Vovash25/IPZ-GestureBot/01_mechanics/NewFinalVersion/Materials/photo_2025-12-03_00-10-28.jpg

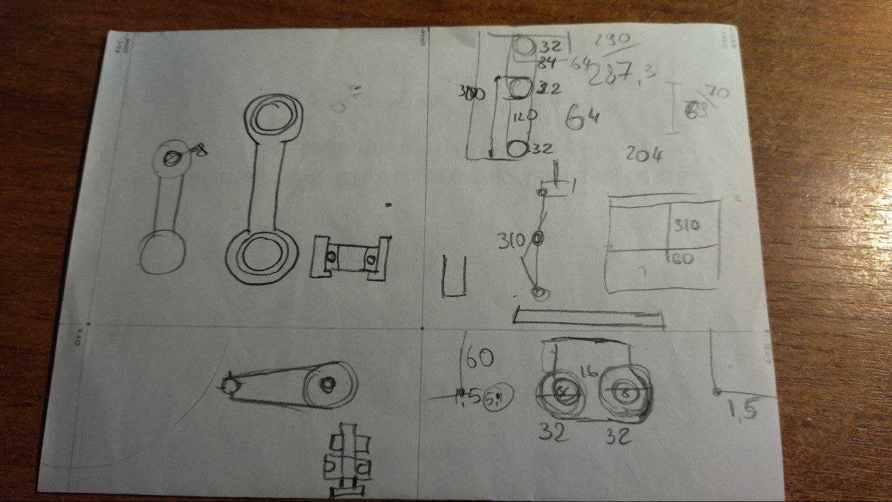
01_mechanics/NewFinalVersion/Materials/photo_2025-12-03_00-10-28.jpg
