Vovash25/IPZ-GestureBot/02_electronics/PSR.jpg

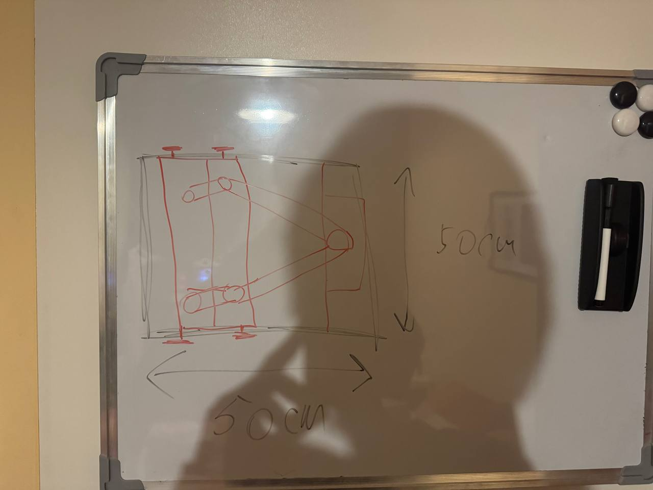
02_electronics/PSR.jpg
