Vovash25/IPZ-GestureBot/README.md

Gesture Bot Project
Projekt zespolowy - robot SCARA sterowany gestami(Gesture Bot)

Sklad zespolu:
- Vyshnovetskyi Volodymyr - Inzynier konstruktor
- Zakhar Semiankevich - Inzynier napedu i elektroniki
- Danylo Chetvertakov - Programista sterowania
- Nikita Tolstoi - Programista interfejsu
- Yehor Maksymenko - Koordynator projektu
