Vovash25/IPZ-GestureBot/02_electronics/CLR.jpg

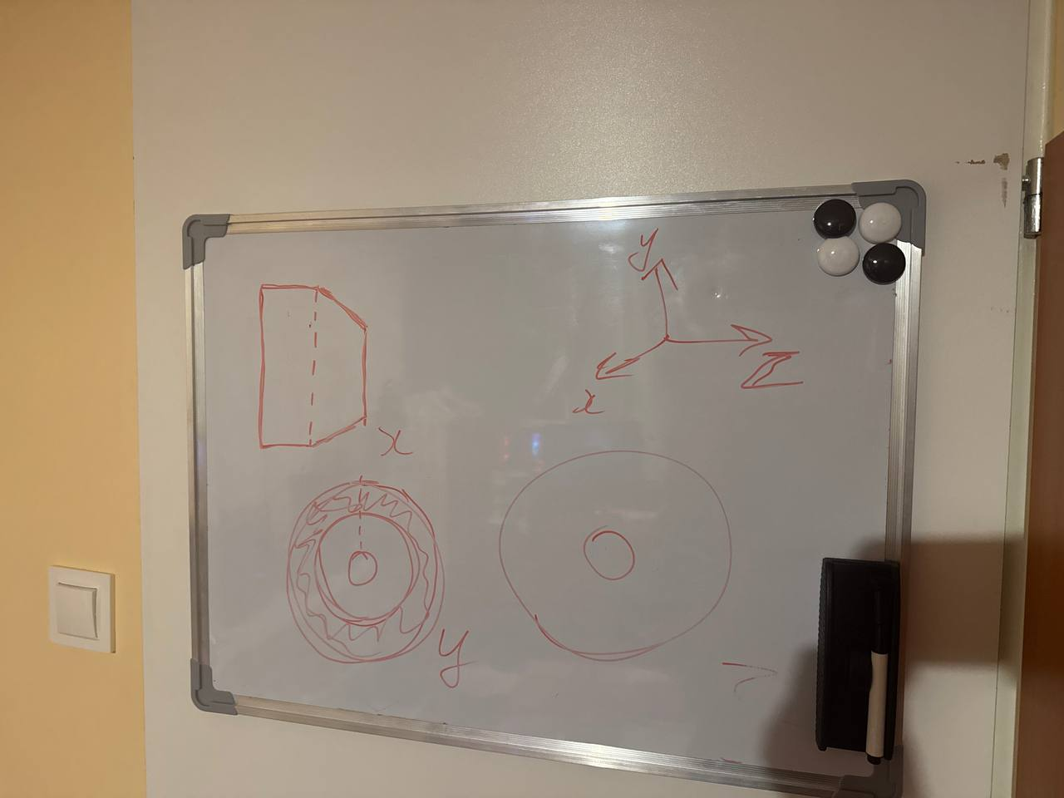
02_electronics/CLR.jpg
