Vovash25/IPZ-GestureBot/02_electronics/PPengine.jpg

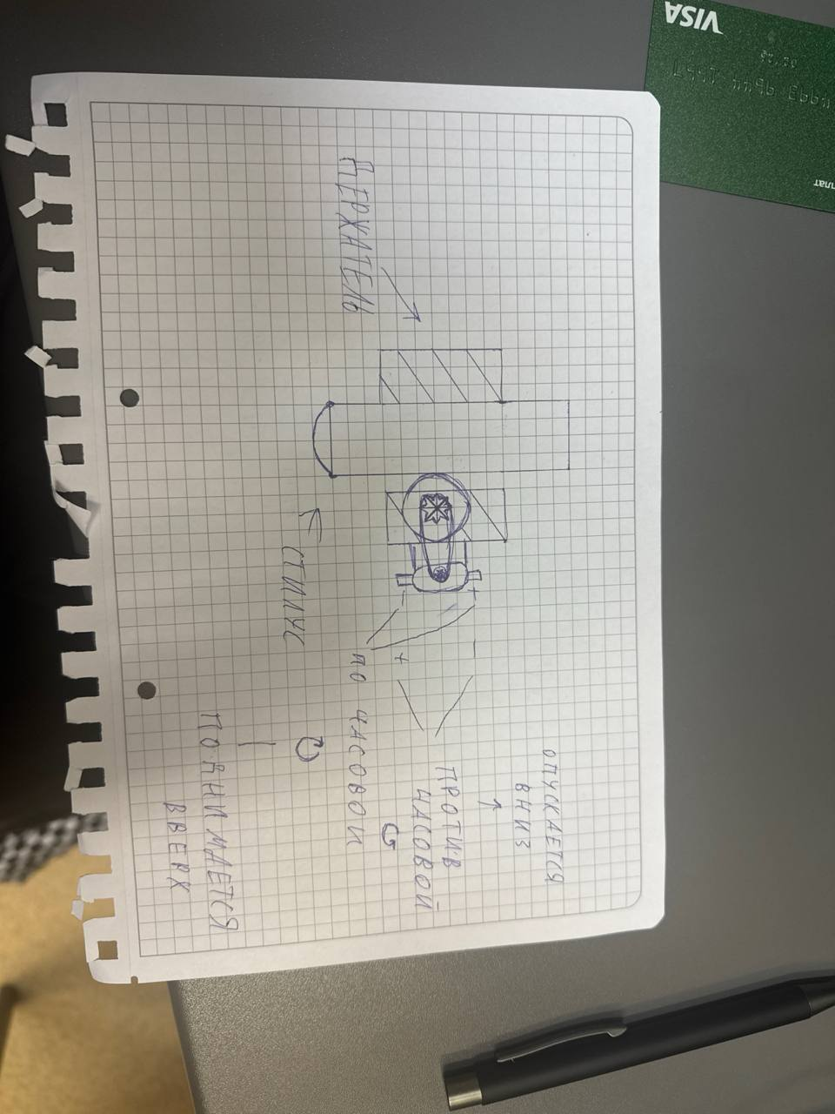
02_electronics/PPengine.jpg
