Vovash25/IPZ-GestureBot/02_electronics/PPHydra.jpg

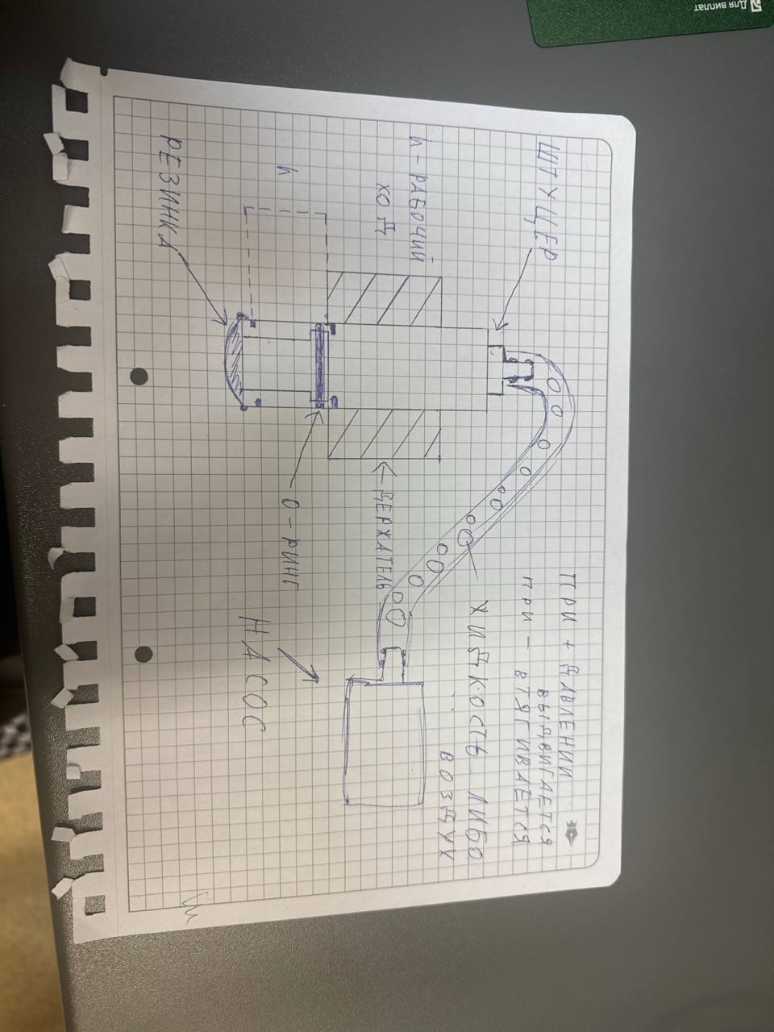
02_electronics/PPHydra.jpg
