Vovash25/IPZ-GestureBot/01_mechanics/NewFinalVersion/Materials/Materials.txt

https://abc-rc.pl/pl/products/lozysko-samonastawne-w-aluminiowej-obudowie-kp08-8mm-podpora-walka-9226.html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
https://allegro.pl/produkt/pierscien-osadczy-din-705-24-mm-nierdzewny-inox-d8f7538b-2cd4-4c75-af28-50b1281246a0?offerId=13463270287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
https://www.amazon.pl/sześciokątne-nierdzewnej-nakrętkami-podkladkami-maszynowych/dp/B0DPWYNDZF/ref=asc_df_B0DPWYNDZF?mcid=3c35ecb657433cf292733566e1e20d55&tag=plshogostdde-21&linkCode=df0&hvadid=719723093451&hvpos=&hvnetw=g&hvrand=13840144792847143092&hvpone=&hvptwo=&hvqmt=&hvdev=c&hvdvcmdl=&hvlocint=&hvlocphy=9067555&hvtargid=pla-2426400582474&hvocijid=13840144792847143092-B0DPWYNDZF-&hvexpln=0&language=pl_PL&gad_source=1&th=1
