Vovash25/IPZ-GestureBot/01_mechanics/NewFinalVersion/Materials/Lozysko.jpg

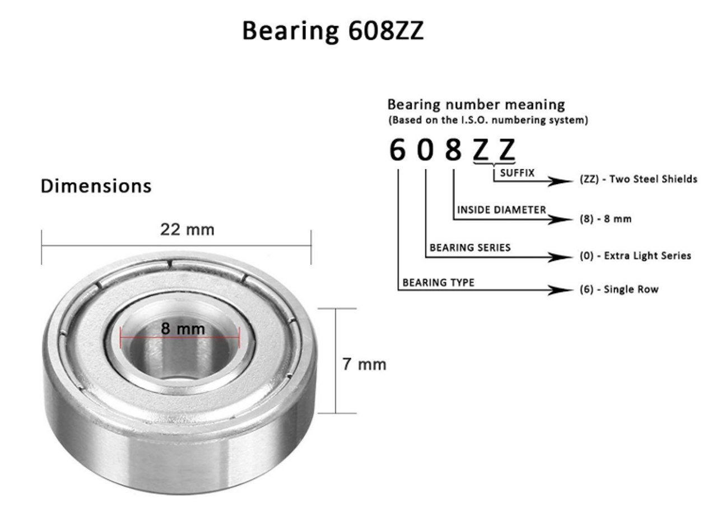
01_mechanics/NewFinalVersion/Materials/Lozysko.jpg
