Vovash25/IPZ-GestureBot/01_mechanics/NewFinalVersion/Materials/photo_2025-11-25_21-36-09.jpg

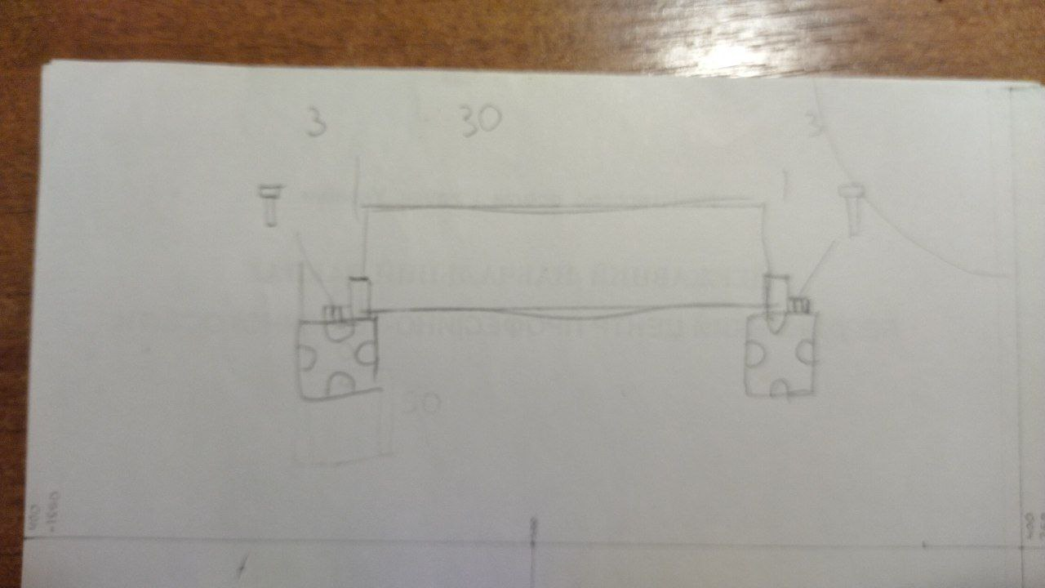
01_mechanics/NewFinalVersion/Materials/photo_2025-11-25_21-36-09.jpg
