Vovash25/IPZ-GestureBot/01_mechanics/NewFinalVersion/Materials/photo_2025-11-25_22-51-11.jpg

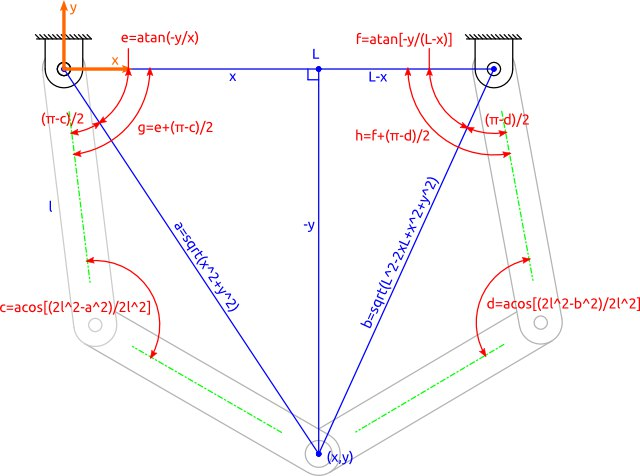
01_mechanics/NewFinalVersion/Materials/photo_2025-11-25_22-51-11.jpg
