Vovash25/IPZ-GestureBot/01_mechanics/NewFinalVersion/Materials/photo_2025-11-26_10-18-21.jpg

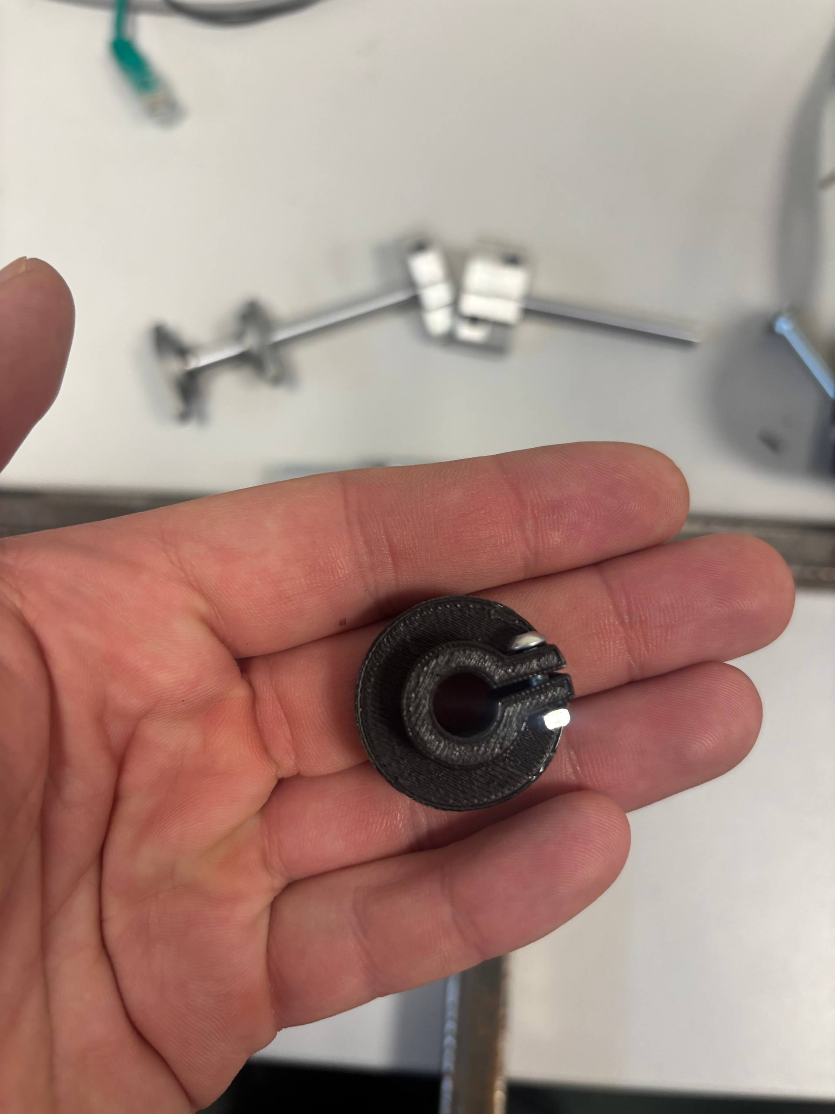
01_mechanics/NewFinalVersion/Materials/photo_2025-11-26_10-18-21.jpg
