Vovash25/IPZ-GestureBot/01_mechanics/NewFinalVersion/Materials/photo_2025-12-02_23-23-39.jpg

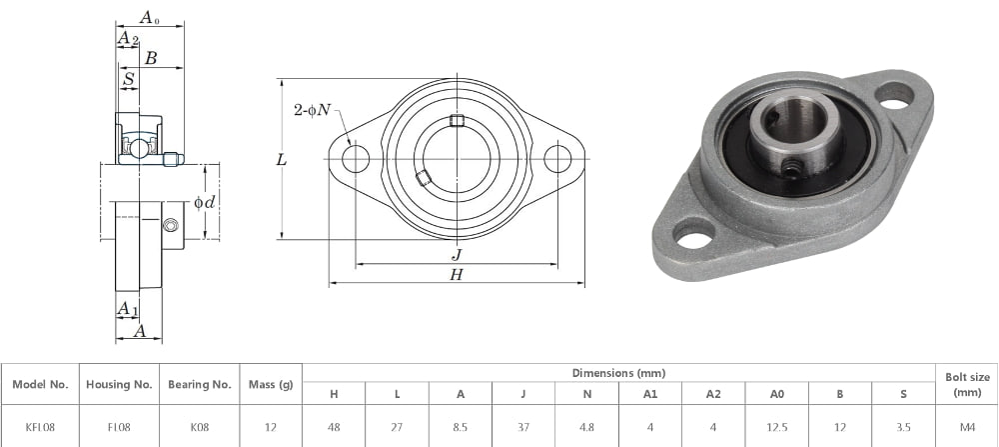
01_mechanics/NewFinalVersion/Materials/photo_2025-12-02_23-23-39.jpg
