Vovash25/IPZ-GestureBot/01_mechanics/NewFinalVersion/Materials/photo_2026-01-06_16-59-09.jpg

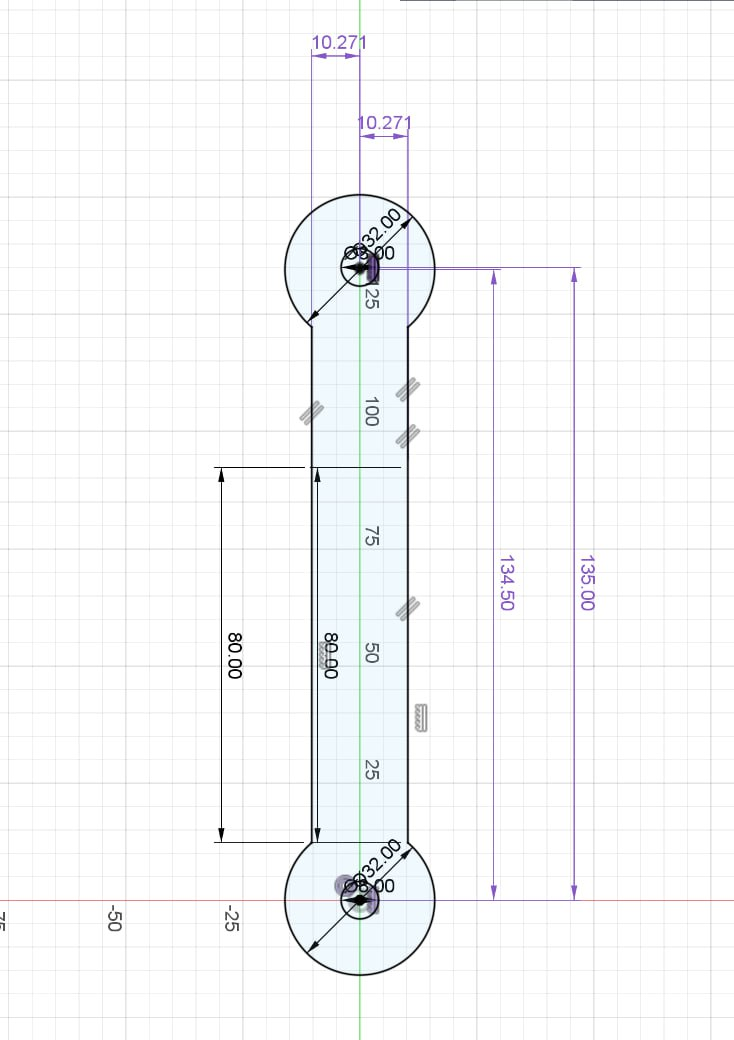
01_mechanics/NewFinalVersion/Materials/photo_2026-01-06_16-59-09.jpg
