Vovash25/IPZ-GestureBot/01_mechanics/NewFinalVersion/Materials/photo_2026-01-28_01-29-15.jpg

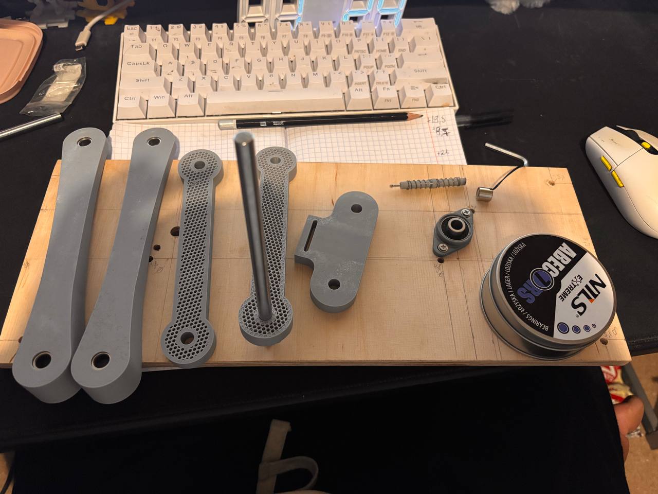
01_mechanics/NewFinalVersion/Materials/photo_2026-01-28_01-29-15.jpg
