Vovash25/IPZ-GestureBot/01_mechanics/NewFinalVersion/Palec/Palec.stl

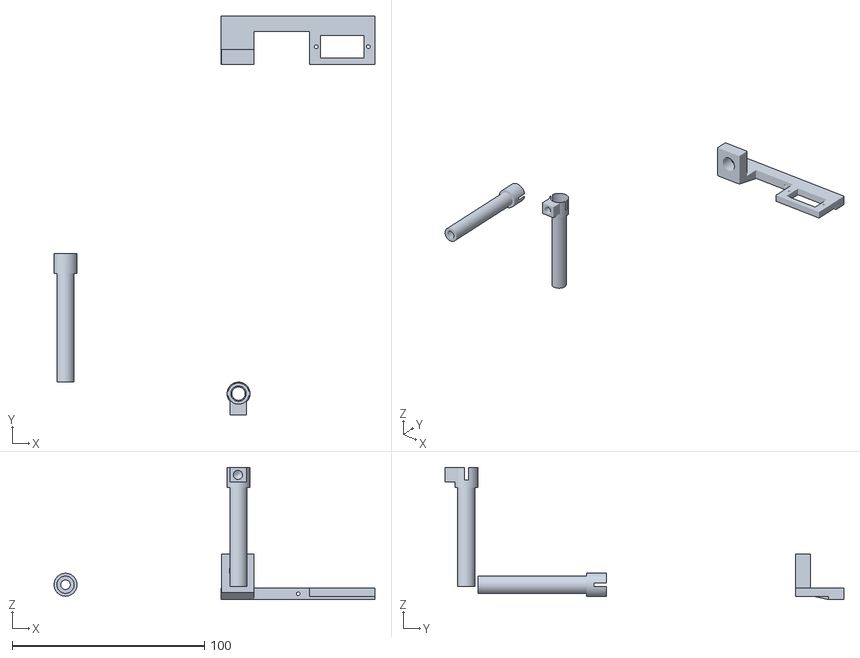
[picture p32: CAD file, 2026-06-16]
01_mechanics/NewFinalVersion/Palec/Palec.stl
167.0 x 207.3 x 68.7
