Vovash25/IPZ-GestureBot/01_mechanics/NewFinalVersion/ServoTr.stl

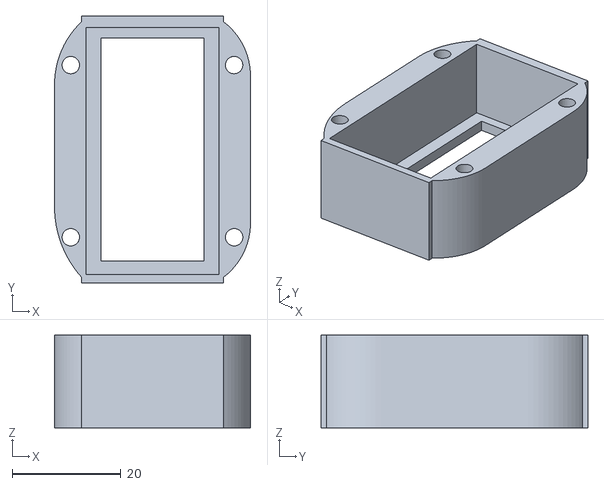
[picture p33: CAD file, 2026-06-16]
01_mechanics/NewFinalVersion/ServoTr.stl
36.0 x 49.0 x 17.0
