Vovash25/IPZ-GestureBot/01_mechanics/TubePalec2.0.stl

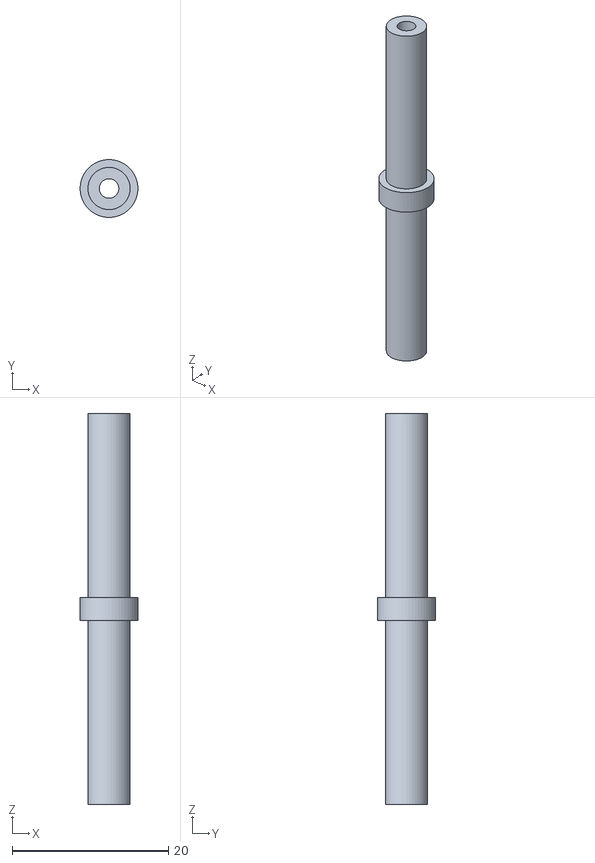
[picture p34: CAD file, 2026-01-28]
01_mechanics/TubePalec2.0.stl
7.39 x 7.40 x 50.0
