Vovash25/IPZ-GestureBot/01_mechanics/NewFinalVersion/firstArm(krotka).stl

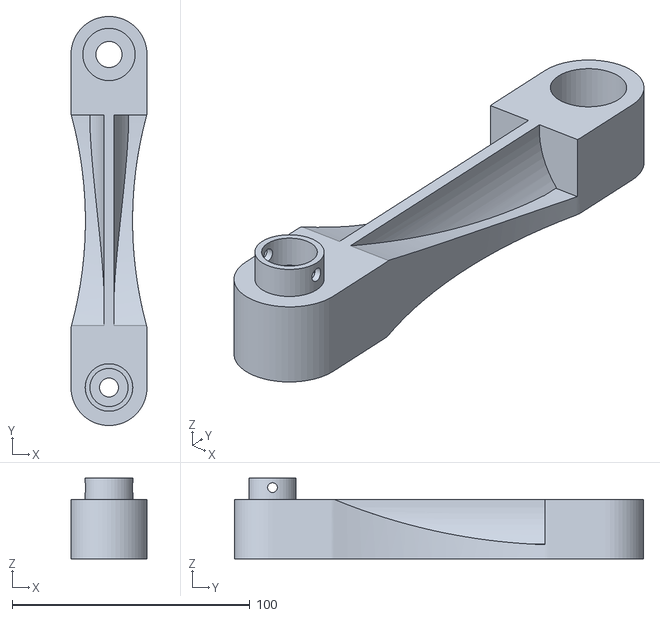
[picture p35: CAD file, 2026-06-16]
01_mechanics/NewFinalVersion/firstArm(krotka).stl
32.0 x 171.9 x 34.0
