Vovash25/IPZ-GestureBot/01_mechanics/Plaform 2.0.stl

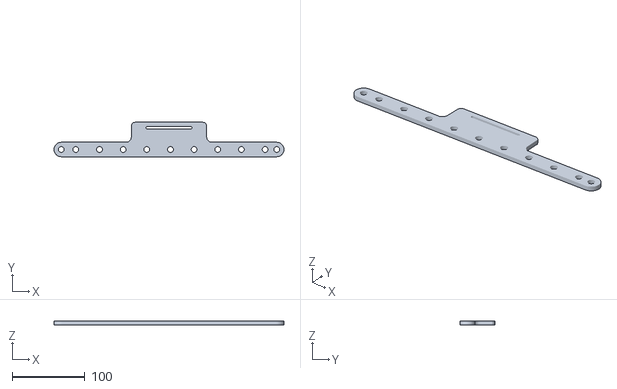
[picture p36: CAD file, 2026-01-28]
01_mechanics/Plaform 2.0.stl
316.0 x 47.5 x 5.00
