Vovash25/IPZ-GestureBot/01_mechanics/Detail1.2.stl

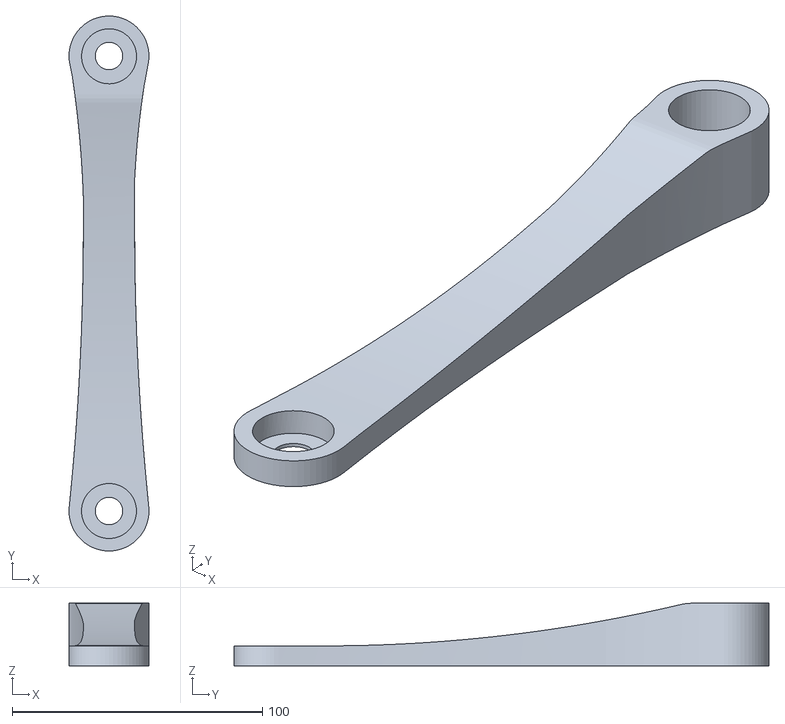
[picture p37: CAD file, 2026-01-28]
01_mechanics/Detail1.2.stl
32.0 x 214.0 x 25.0
