Vovash25/IPZ-GestureBot/01_mechanics/NewFinalVersion/MiddleConnections.stl

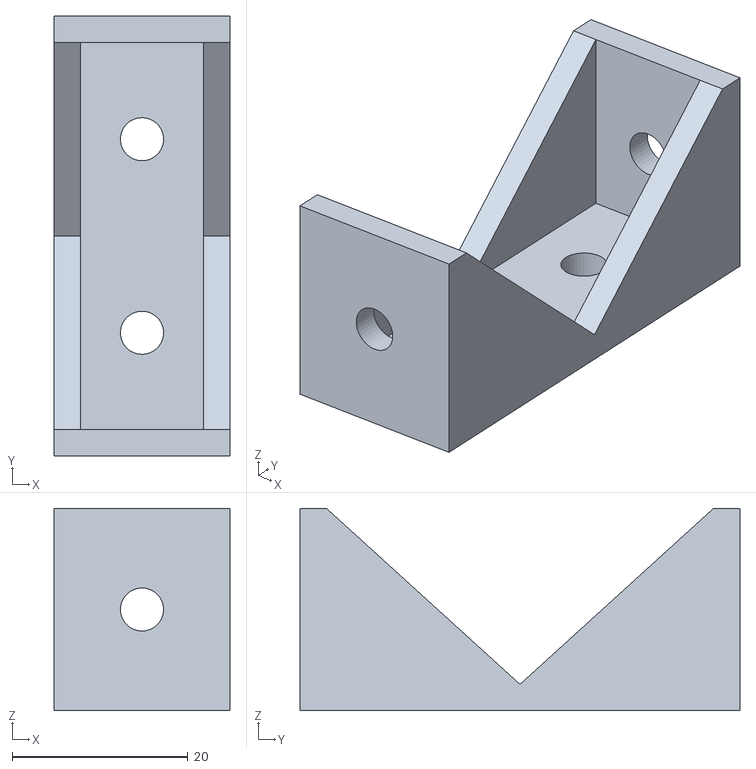
[picture p38: CAD file, 2026-06-16]
01_mechanics/NewFinalVersion/MiddleConnections.stl
20.0 x 50.0 x 23.0
