Vovash25/IPZ-GestureBot/01_mechanics/Detail2.0.stl

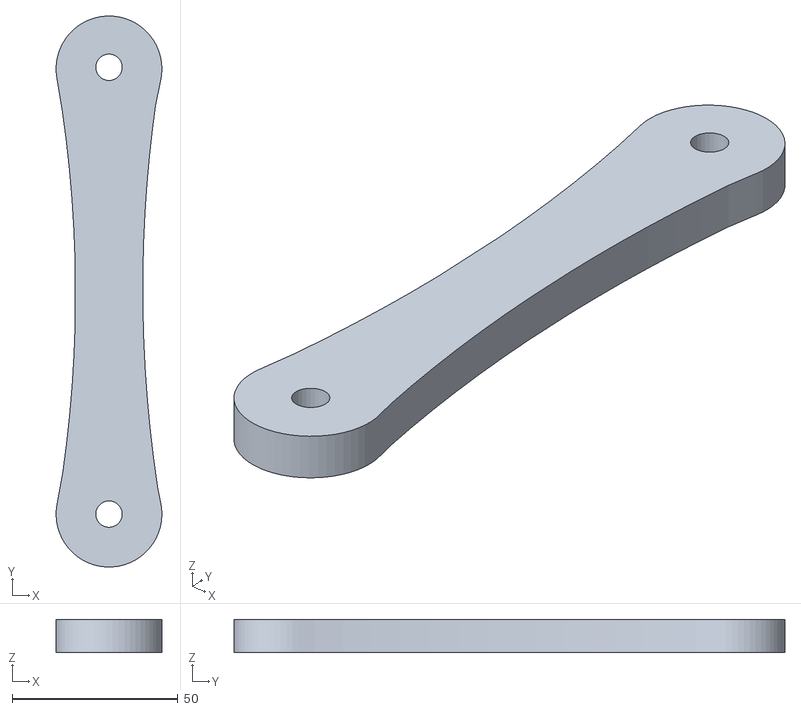
[picture p39: CAD file, 2026-01-28]
01_mechanics/Detail2.0.stl
32.0 x 166.5 x 10.0
