Vovash25/IPZ-GestureBot/01_mechanics/NewFinalVersion/Arm(dluga).stl

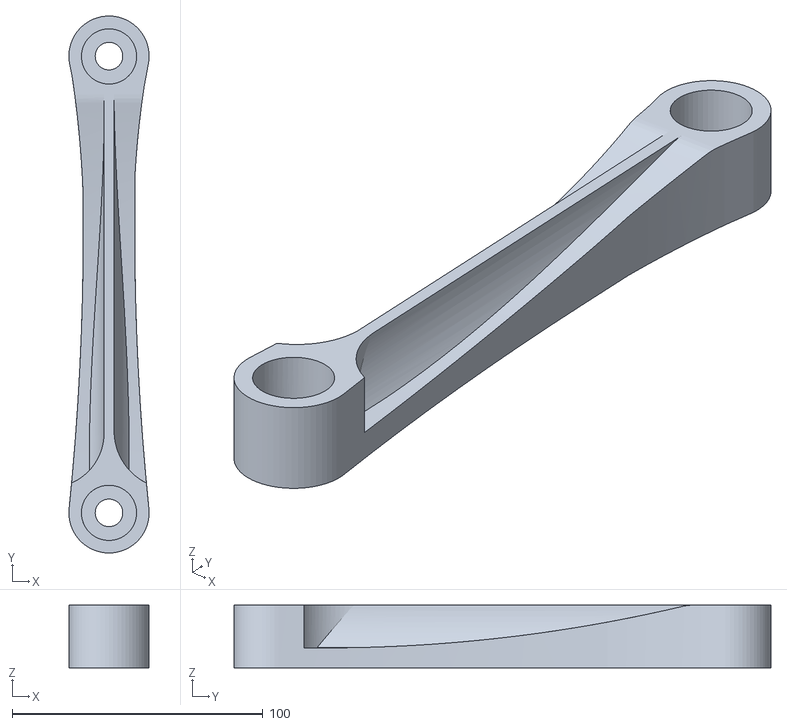
[picture p40: CAD file, 2026-06-16]
01_mechanics/NewFinalVersion/Arm(dluga).stl
32.0 x 214.0 x 25.0
