Vovash25/IPZ-GestureBot/01_mechanics/Detail1.0.stl

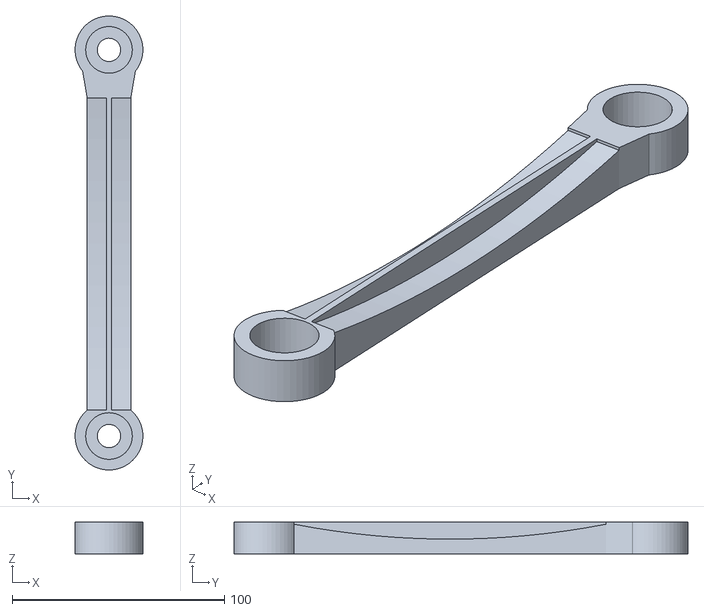
[picture p41: CAD file, 2026-01-28]
01_mechanics/Detail1.0.stl
32.0 x 214.0 x 15.0
