Vovash25/IPZ-GestureBot/01_mechanics/NewFinalVersion/SmallConnection.stl

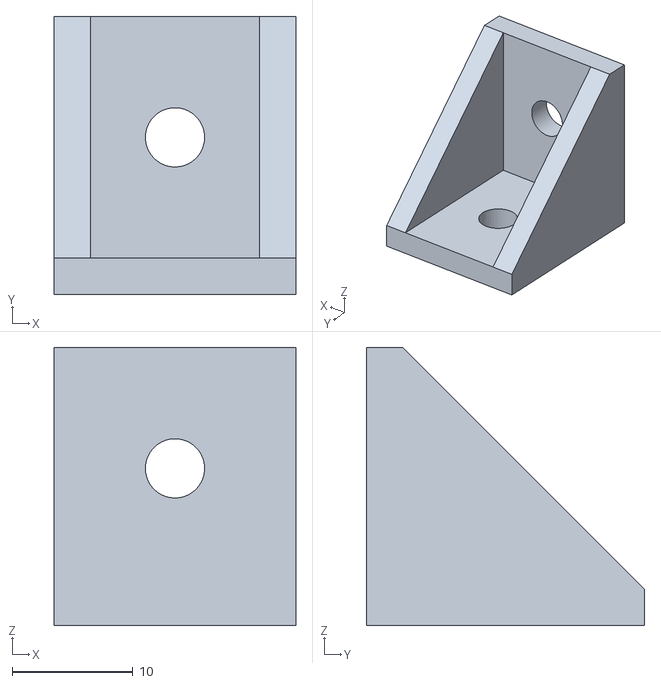
[picture p42: CAD file, 2026-06-16]
01_mechanics/NewFinalVersion/SmallConnection.stl
20.0 x 23.0 x 23.0
