Vovash25/IPZ-GestureBot/01_mechanics/3030_M3_stl.stl

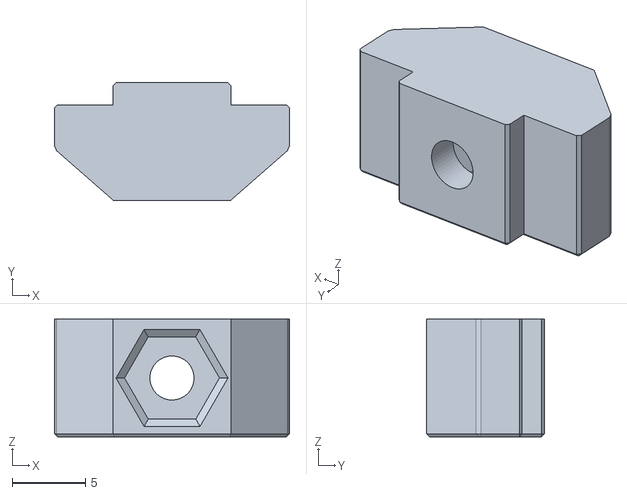
[picture p43: CAD file, 2025-12-03]
01_mechanics/3030_M3_stl.stl
16.0 x 8.00 x 8.00
