Vovash25/IPZ-GestureBot/01_mechanics/NewFinalVersion/Connections.stl

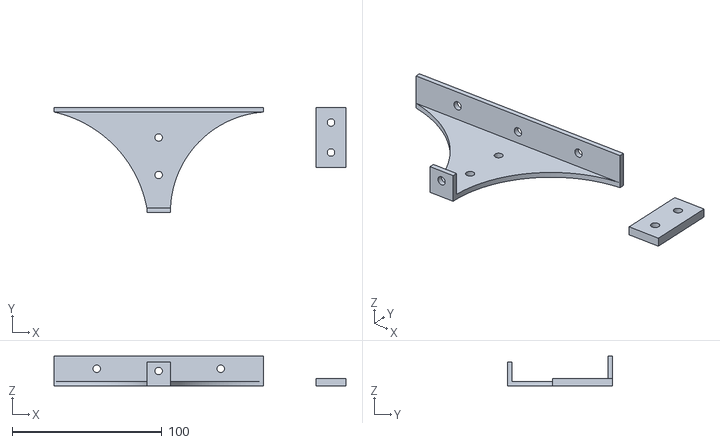
[picture p44: CAD file, 2026-06-16]
01_mechanics/NewFinalVersion/Connections.stl
194.9 x 70.0 x 20.0
