Vovash25/IPZ-GestureBot/01_mechanics/NewFinalVersion/ServoDetail.stl

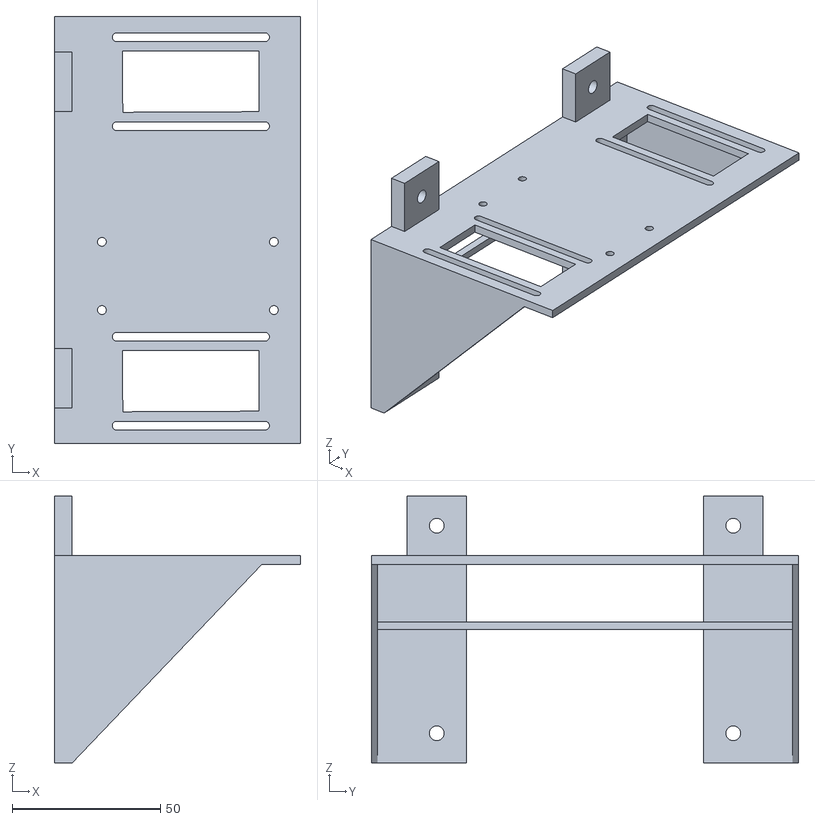
[picture p45: CAD file, 2026-06-16]
01_mechanics/NewFinalVersion/ServoDetail.stl
83.0 x 144.0 x 90.0
