Vovash25/IPZ-GestureBot/01_mechanics/NewFinalVersion/ramka.stl

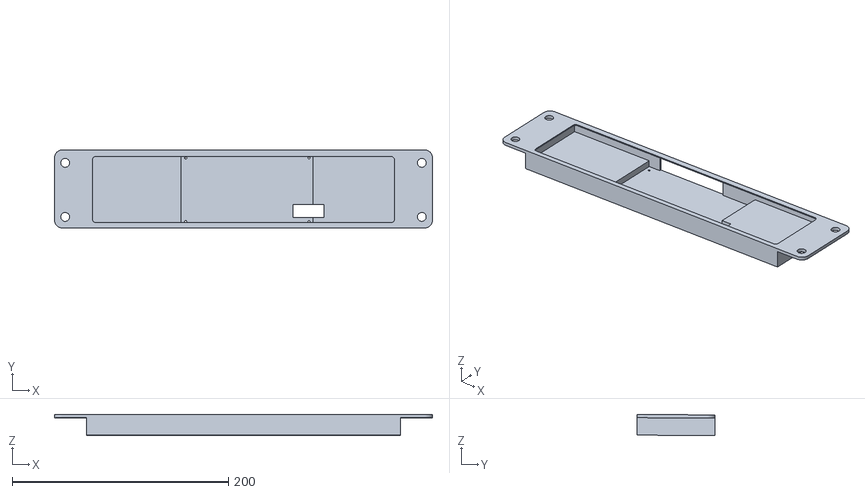
[picture p46: CAD file, 2026-06-16]
01_mechanics/NewFinalVersion/ramka.stl
349.7 x 72.2 x 19.5
