Vovash25/IPZ-GestureBot/01_mechanics/Platform.stl

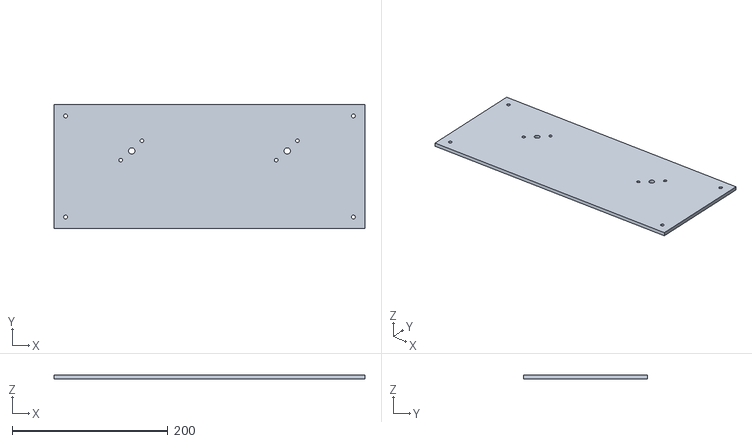
[picture p47: CAD file, 2025-12-03]
01_mechanics/Platform.stl
400.0 x 160.0 x 5.00
