Vovash25/IPZ-GestureBot/01_mechanics/Clutch.stl

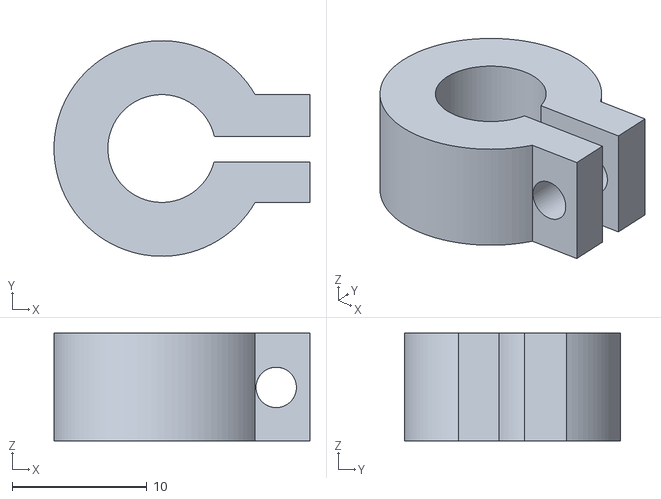
[picture p48: CAD file, 2025-12-03]
01_mechanics/Clutch.stl
19.0 x 16.0 x 8.00
