Vovash25/IPZ-GestureBot/01_mechanics/PlatformEnding.stl

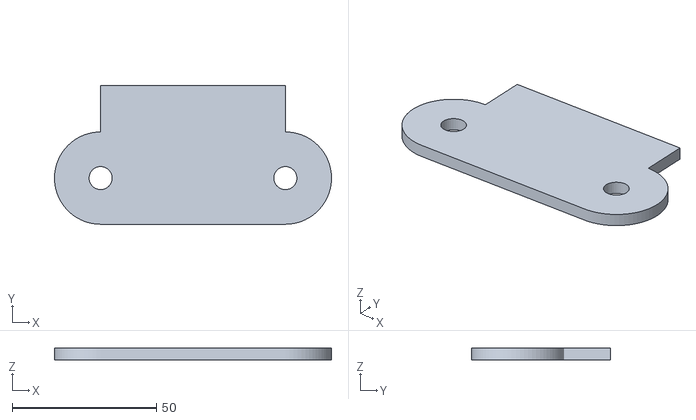
[picture p49: CAD file, 2025-12-03]
01_mechanics/PlatformEnding.stl
96.0 x 48.0 x 4.00
