Vovash25/IPZ-GestureBot/01_mechanics/Karkas.stl

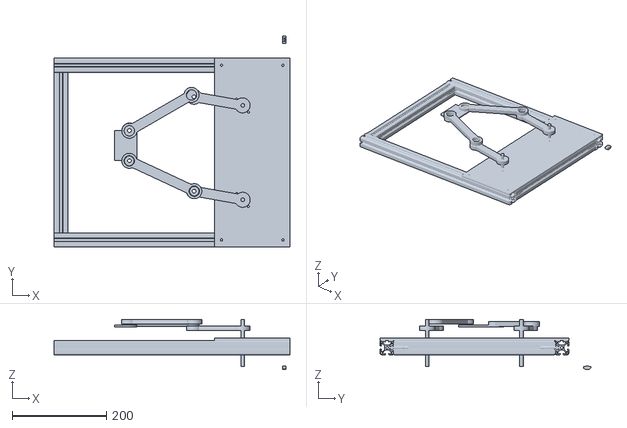
[picture p50: CAD file, 2025-12-03]
01_mechanics/Karkas.stl
500.0 x 447.0 x 106.5
