Vovash25/IPZ-GestureBot/(list of files, cad)

Other CAD files:
01_mechanics/Bolt.stl
01_mechanics/NewFinalVersion/Prototyp.f3z
01_mechanics/Old/Bolt.stl
