Vovash25/IPZ-GestureBot/(commit log)

2025-11-25 mechanics start
    [item_a8caf47a6b03491d854d950e2a1c47561.stl, uchwyty.3mf]
2025-12-02 Implement Kinematics and Gesture Logic
2025-12-03 3d model bazic update
    [3030_M3_stl.stl, Bolt.stl, Clutch.stl, Detail1.stl, Detail2.stl, Karkas.stl, Platform.stl, PlatformEnding.stl]
2026-01-06 Update materials
2026-01-28 Figure + gesture, fan control system
2026-06-16 Last changes
    [log_coordinates.csv]
2026-06-16 Final Mechanics
    [3030_M3_stl.stl, Arm(dluga).stl, Bolt.stl, Clutch.stl, Connections.stl, Detail1.0.stl, Detail1.2.stl, Detail2.0.stl]
